zarattee/velocista/img/TQFP_ARDUINO_PINOUT.jpg

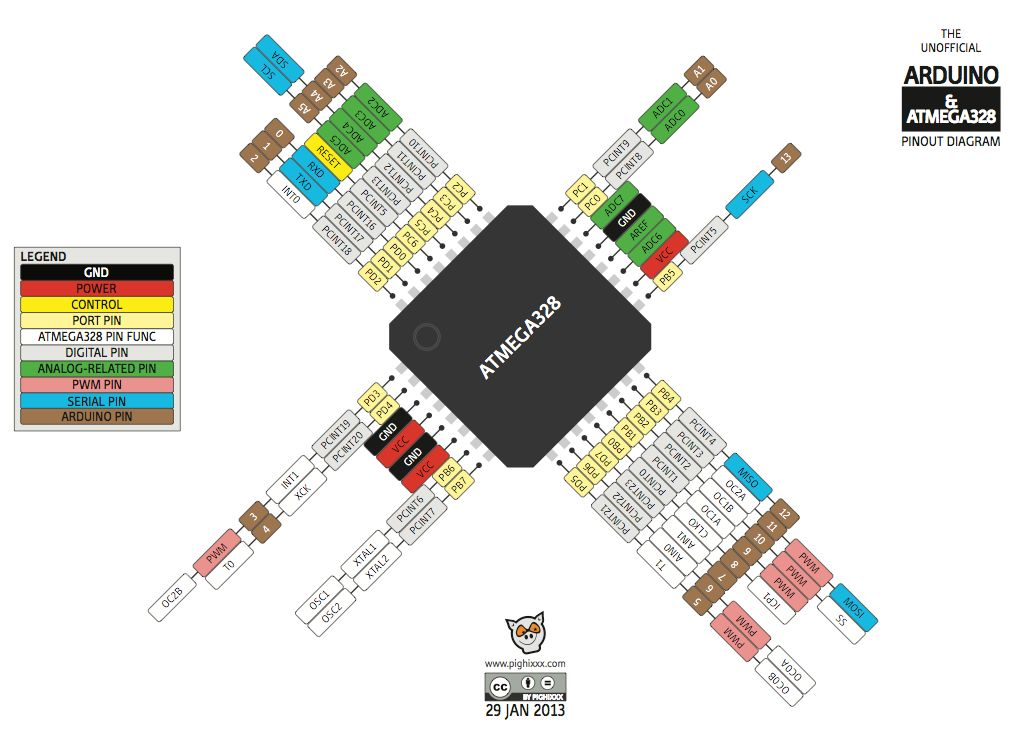
img/TQFP_ARDUINO_PINOUT.jpg
