zarattee/velocista/img/3D_VIEW_C.jpg

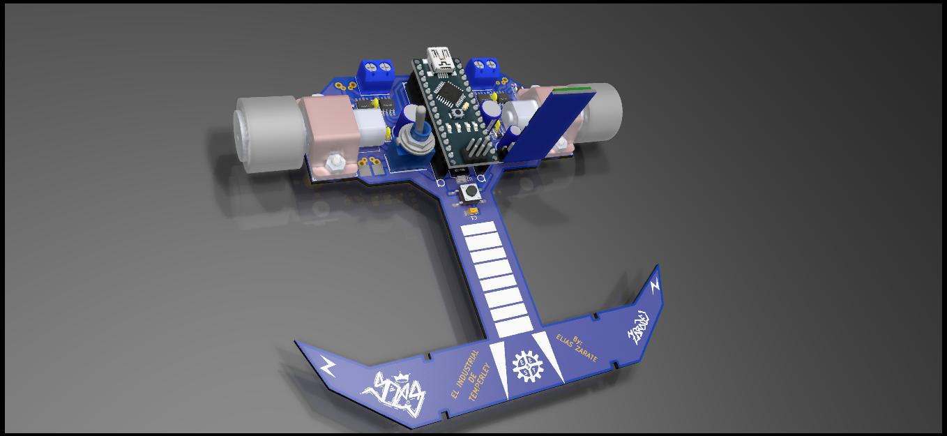
img/3D_VIEW_C.jpg
