zarattee/velocista/img/3D_VIEW.jpg

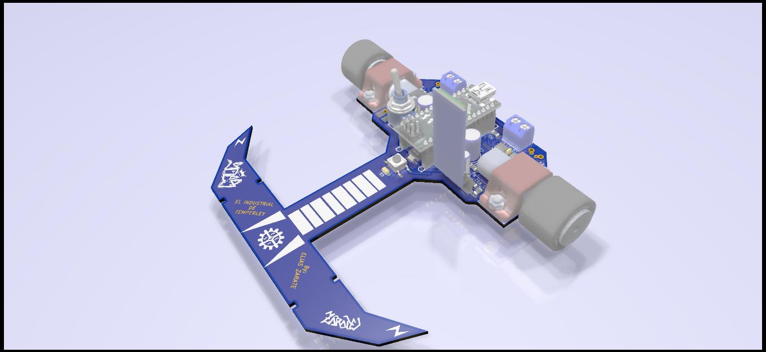
img/3D_VIEW.jpg
