zarattee/velocista/img/3D_VIEW_D.jpg

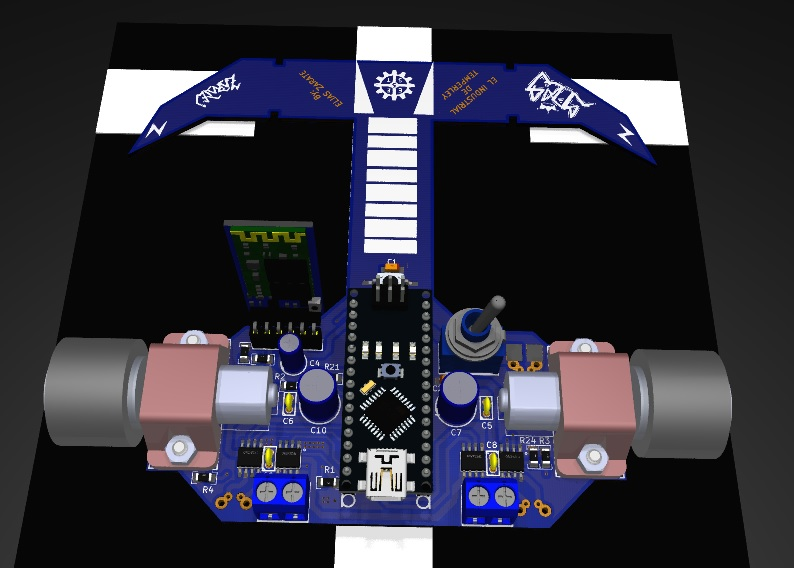
img/3D_VIEW_D.jpg
