zarattee/velocista/img/Config_Drill.jpg

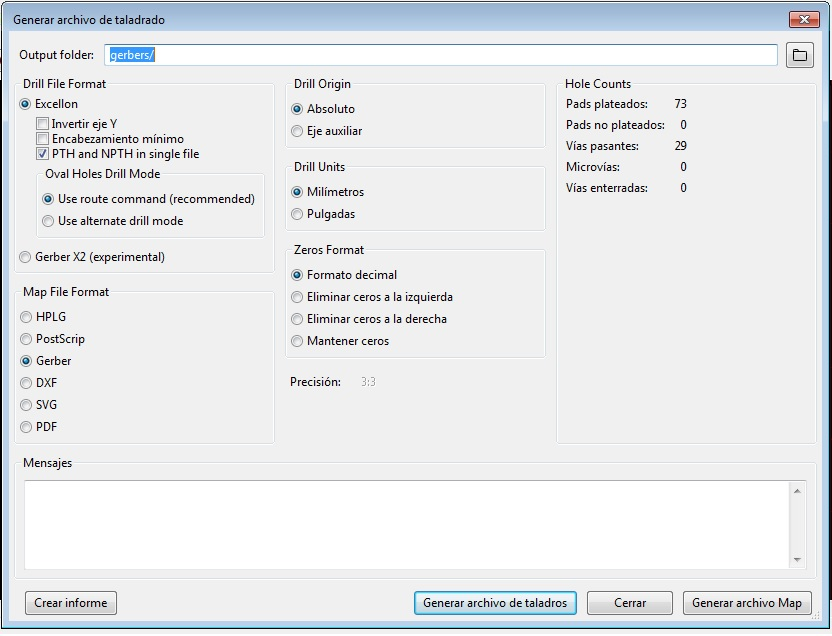
img/Config_Drill.jpg
