zarattee/velocista/doc/BOM_Velocista.xls

Sheet: LISTA DE MATERIALES
Lista de materiales
Proyecto: |  | Robot Velocista con 2 helices
Curso: |  | 4Dev
Fecha: |  | 2021-01-08
Autor: |  | Elias Zarate
Moneda: |  | USD | Tipo de cambio: -
 | Designator | Footprint | CANT. | Value | U. Price | Subtotal | % | Proveedor | MPN | DIGI-KEY PART NUMBER
1 | J1 | arduino_nano_header | 1 | Arduino_Nano_Header | 0.440 | 0.440 | 0.65% | ML
2 | C1 | CAP_TAN_A | 1 | 10UF | 0.286 | 0.286 | 0.42% | Digikey.link (https://www.digikey.com/en/products/detail/kemet/T491A106M016AT/818548) | T491A106M016AT | 399-3687-2-ND
3 | SW | Pulsador_4_SMD | 1 | START | 0.177 | 0.177 | 0.26% | Digikey.link (https://www.digikey.com/en/products/detail/e-switch/TL3305AF160QG/5816181) | TL3305AF160QG | EG5350TR-ND
4 | SW3 | SW_SPDT_TH_Vertical | 1 | SW_SPDT | 1.150 | 1.150 | 1.70% | Monarca.link (https://www.monarcaelectronica.com.ar/productos/interruptor-de-palanca-3-pines-na-nc-3a-250v-mona/)
5 | J2,J3,J4,J6,J7 | BORNERA2_DUO | 5 | ALIMENTACION | 0.150 | 0.750 | 1.11% | ELEMON | XY305-2P AZUL | BO5811900
6 | J5 | HC-05 | 1 | BLUETOOTH | 0.110 | 0.110 | 0.16% | ML
7 | C9,C8,C6,C5 | CAP_0.1 | 4 | 100nf | 0.110 | 0.438 | 0.65% | Digikey.link (https://www.digikey.com/en/products/detail/kemet/C315C104M5U5TA/817927) | C315C104M5U5TA | 399-4151-ND
8 | R2,R9,R10,R11,R12,R17,R18,R19,R20 | R_1206 | 9 | 10K | 0.027 | 0.246 | 0.36% | Digikey.link (https://www.digikey.com/en/products/detail/te-connectivity-passive-product/CRG1206F10K/2389909) | CRG1206F10K | A106069TR-ND
9 | U13,U1,U11,U12 | SSOP-8 | 4 | DRV8872 | 2.428 | 9.712 | 14.39% | Digikey.link (https://www.digikey.com/en/products/detail/texas-instruments/DRV8872DDA/6571845) | DRV8872DDA | 296-46512-5-ND
10 | C4 | CAP_ELEC_5x11mm | 1 | 100uf | 0.100 | 0.100 | 0.15% | Digikey.link (https://www.digikey.com/en/products/detail/w%C3%BCrth-elektronik/860010372006/5728555) | 860010372006 | 732-8598-1-ND
11 | C3 | C_1206 | 1 | 100nf | 0.036 | 0.036 | 0.05% | Digikey.link (https://www.digikey.com/en/products/detail/kemet/C1206C104K5RAC7800/411248) | C1206C104K5RAC7800 | 399-C1206C104K5RAC7800CT-ND
12 | C2 | CAP_TAN_A | 1 | 100uf | 0.616 | 0.616 | 0.91% | Digikey.link (https://www.digikey.com/en/products/detail/avx-corporation/F931C107MCCAJ6/6156133) | F931C107MCCAJ6 | 478-9997-2-ND
13 | R5,R6,R7,R8,R13,R14,R15,R16 | R_1206 | 8 | 220 | 0.027 | 0.213 | 0.32% | Digikey.link (https://www.digikey.com/en/products/detail/vishay-dale/CRCW1206220RFKEA/1176566) | CRCW1206220RFKEA | 541-220FTR-ND
14 | R21,R22,R23 | R_1206 | 3 | 1K | 0.028 | 0.083 | 0.12% | Digikey.link (https://www.digikey.com/en/products/detail/te-connectivity-passive-product/CRGCQ1206F1K0/8576412) | CRGCQ1206F1K0 | A129810TR-ND
15 | U2 | SOT223 | 1 | LM1117-SOT | 0.985 | 0.985 | 1.46% | Digikey.link (https://www.digikey.com/en/products/detail/texas-instruments/LM1117MP-5-0-NOPB/363590) | LM1117MP-5.0/NOPB | LM1117MP-5.0/NOPBTR-ND
16 | U3,U4,U5,U6,U7,U8,U9,U10 | QRE1113GR | 8 | QRE1113 | 0.667 | 5.336 | 7.91% | Digikey.link (https://www.digikey.com/en/products/detail/on-semiconductor/QRE1113GR/965451) | QRE1113GR | QRE1113GRTR-ND
17 | C7,C10 | CAP_ELEC_8x11.5mm | 2 | 100uF | 1.733 | 3.466 | 5.14% | Digikey.link (https://www.digikey.com/en/products/detail/cornell-dubilier-electronics-cde/SEK101M050ST/1627120) | SEK101M050ST | 338-1725-ND
19 | R3,R4,R1,R24 | R_1206 | 4 | Rsense | 0.363 | 1.452 | 2.15% | Digikey.link (https://www.digikey.com/en/products/detail/panasonic-electronic-components/ERJ-8CWJR025V/4927026) | ERJ-8CWJR025V | P0.025BWTR-ND
20 | PCB |  | 1 |  | 10.000 | 10.000 | 14.82%
21 | Motor | Micro motor Pololu 6000rpm 6V | 2 |  | 15.950 | 31.900 | 47.26% | Digikey.link (https://www.digikey.com/en/products/detail/pololu-corporation/1000/10449928) | 1000 | 2183-1000-ND
 |  | Notas |  |  | TOTAL | 67.495
 | https://www.jsumo.com/storm-pid-controlled-fast-line-follower |  |  |  |  | 290
 | https://www.sumozade.com/en/product/linecraft-fast-line-follower-robot-kit-4000rpm-assembled |  |  |  |  | 279
 | https://ja-bots.com/producto/seguidor-de-linea-fastbot/ |  |  |  |  | 160

Sheet: PCBA
Lista de materiales
Proyecto: |  | Robot Velocista con 2 helices
Curso: |  | 4Dev
Fecha: |  | 2021-01-08
Autor: |  | Elias Zarate
Moneda: |  | USD | Tipo de cambio: -
 | Designator | Footprint | CANT. | Value | Proveedor | MPN | DIGI-KEY PART NUMBER
1 | J1 | arduino_nano_header | 1 | Arduino_Nano_Header
2 | C1 | CAP_TAN_A | 1 | 10uF 16V | Digikey.link (https://www.digikey.com/en/products/detail/kemet/T491A106M016AT/818548) | T491A106M016AT | 399-3687-2-ND
3 | SW | Pulsador_4_SMD | 1 | START | Digikey.link (https://www.digikey.com/en/products/detail/e-switch/TL3305AF160QG/5816181) | TL3305AF160QG | EG5350TR-ND
4 | SW3 | SW_SPDT_TH_Vertical | 1 | SW_SPDT | Monarca.link (https://www.monarcaelectronica.com.ar/productos/interruptor-de-palanca-3-pines-na-nc-3a-250v-mona/)
5 | J2,J3,J4,J6,J7 | BORNERA2_DUO | 5 | Paso 5mm | ELEMON | XY305-2P AZUL | BO5811900
6 | J5 | HC-05 | 1 | BLUETOOTH | ML
7 | C9,C8,C6,C5 | CAP_0.1 | 4 | 100nf | Digikey.link (https://www.digikey.com/en/products/detail/kemet/C315C104M5U5TA/817927) | C315C104M5U5TA | 399-4151-ND
8 | R2,R9,R10,R11,R12,R17,R18,R19,R20 | R_1206 | 9 | 10K | Digikey.link (https://www.digikey.com/en/products/detail/te-connectivity-passive-product/CRG1206F10K/2389909) | CRG1206F10K | A106069TR-ND
9 | U13,U1,U11,U12 | SSOP-8 | 4 | DRV8872 | Digikey.link (https://www.digikey.com/en/products/detail/texas-instruments/DRV8872DDA/6571845) | DRV8872DDA | 296-46512-5-ND
10 | C4 | CAP_ELEC_5x11mm | 1 | 100uF 16V | Digikey.link (https://www.digikey.com/en/products/detail/w%C3%BCrth-elektronik/860010372006/5728555) | 860010372006 | 732-8598-1-ND
11 | C3 | C_1206 | 1 | 100nF 50V | Digikey.link (https://www.digikey.com/en/products/detail/kemet/C1206C104K5RAC7800/411248) | C1206C104K5RAC7800 | 399-C1206C104K5RAC7800CT-ND
12 | C2 | CAP_TAN_A | 1 | 100uF 16V | Digikey.link (https://www.digikey.com/en/products/detail/avx-corporation/F931C107MCCAJ6/6156133) | F931C107MCCAJ6 | 478-9997-2-ND
13 | R5,R6,R7,R8,R13,R14,R15,R16 | R_1206 | 8 | 220 | Digikey.link (https://www.digikey.com/en/products/detail/vishay-dale/CRCW1206220RFKEA/1176566) | CRCW1206220RFKEA | 541-220FTR-ND
14 | R21,R22,R23 | R_1206 | 3 | 1K | Digikey.link (https://www.digikey.com/en/products/detail/te-connectivity-passive-product/CRGCQ1206F1K0/8576412) | CRGCQ1206F1K0 | A129810TR-ND
15 | U2 | SOT223 | 1 | LM1117-SOT | Digikey.link (https://www.digikey.com/en/products/detail/texas-instruments/LM1117MP-5-0-NOPB/363590) | LM1117MP-5.0/NOPB | LM1117MP-5.0/NOPBTR-ND
16 | U3,U4,U5,U6,U7,U8,U9,U10 | QRE1113GR | 8 | QRE1113GR | Digikey.link (https://www.digikey.com/en/products/detail/on-semiconductor/QRE1113GR/965451) | QRE1113GR | QRE1113GRTR-ND
17 | C7,C10 | CAP_ELEC_8x11.5mm | 2 | 100uF 16V | Digikey.link (https://www.digikey.com/en/products/detail/cornell-dubilier-electronics-cde/SEK101M050ST/1627120) | SEK101M050ST | 338-1725-ND
19 | R3,R4,R1,R24 | R_1206 | 4 | Rsense | Digikey.link (https://www.digikey.com/en/products/detail/panasonic-electronic-components/ERJ-8CWJR025V/4927026) | ERJ-8CWJR025V | P0.025BWTR-ND
20 | PCB |  | 1
 |  | Notas
