zarattee/velocista/doc/lista de componentes.xls

Lista de materiales
Proyecto:
Curso:
Fecha:
Autor:
Moneda: |  | $ (Pesos) | Tipo de cambio: -
 | Designator | Footprint | CANT. | Value | Unit Price | Subtotal | Proveedor | MPN | DIGI-KEY PART NUMBER
1 | J1 | arduino_nano_header | 1 | Arduino_Nano_Header |  | 0.00
2 | C1 | CAP_TAN_A | 1 | 10UF |  | 0.00 | https://www.digikey.com/en/products/detail/kemet/T491A106M016AT/818548 | T491A106M016AT | 399-3687-2-ND
3 | SW | Pulsador_4_SMD | 1 | START |  | 0.00 | https://www.digikey.com/en/products/detail/e-switch/TL3305AF160QG/5816181 | TL3305AF160QG | EG5350TR-ND
4 | SW3 | SW_SPDT_TH_Vertical | 1 | SW_SPDT |  | 0.00
5 | J2,J3,J4,J6,J7 | BORNERA2_DUO | 5 | ALIMENTACION,BORNES DE LOS MOTORES |  | 0.00
6 | J5 | HC-05 | 1 | BLUETOOTH |  | 0.00
7 | C9,C8,C6,C5 | CAP_0.1 | 4 | 100nf |  | 0.00
8 | R2,R9,R10,R11,R12,R17,R18,R19,R20 | R_1206 | 9 | 10K |  | 0.00 | https://www.digikey.com/en/products/detail/te-connectivity-passive-product/CRG1206F10K/2389909 | CRG1206F10K | A106069TR-ND
9 | U13,U1,U11,U12 | SSOP-8 | 4 | DRV8872 |  | 0.00 | https://www.digikey.com/en/products/detail/texas-instruments/DRV8872DDA/6571845 | DRV8872DDA | 296-46512-5-ND
10 | C4 | CAP_ELEC_5x11mm | 1 | 100uf |  | 0.00 | https://www.digikey.com/en/products/detail/w%C3%BCrth-elektronik/860010372006/5728555 | 860010372006 | 732-8598-1-ND
11 | C3 | C_1206 | 1 | 100nf |  | 0.00 | https://www.digikey.com/en/products/detail/samsung-electro-mechanics/CL10B104KC8VPNC/11487748 | CL10B104KC8VPNC | 1276-CL10B104KC8VPNCTR-ND
12 | C2 | CAP_TAN_A | 1 | 100uf |  |  | https://www.digikey.com/en/products/detail/avx-corporation/F931C107MCCAJ6/6156133 | F931C107MCCAJ6 | 478-9997-2-ND
13 | R5,R6,R7,R8,R13,R14,R15,R16 | R_1206 | 8 | 220 |  |  | https://www.digikey.com/en/products/detail/vishay-dale/CRCW1206220RFKEA/1176566 | CRCW1206220RFKEA | 541-220FTR-ND
14 | R21,R22,R23 | R_1206 | 3 | 1K |  |  | https://www.digikey.com/en/products/detail/te-connectivity-passive-product/CRGCQ1206F1K0/8576412 | CRGCQ1206F1K0 | A129810TR-ND
15 | U2 | SOT223 | 1 | LM1117-SOT |  |  | https://www.digikey.com/en/products/detail/texas-instruments/LM1117MP-5-0-NOPB/363590 | LM1117MP-5.0/NOPB | LM1117MP-5.0/NOPBTR-ND
16 | U3,U4,U5,U6,U7,U8,U9,U10 | QRE1113GR | 8 | QRE1113 |  |  | https://www.digikey.com/en/products/detail/on-semiconductor/QRE1113GR/965451 | QRE1113GR | QRE1113GRTR-ND
17 | C7,C10 | CAP_ELEC_8x11.5mm | 2 | 1OOuf |  |  | https://www.digikey.com/en/products/detail/rubycon/16YXG100MEFC5X11/3134093 | 16YXG100MEFC5X11 | 1189-1135-ND
18 | R3,R24 | R_1206 | 2 | 0.25 |  | 0.00
19 | R4,R1 | R_1206 | 1 | Rsense |  | 0.00 | https://www.digikey.com/en/products/detail/panasonic-electronic-components/ERJ-8CWJR025V/4927026 | ERJ-8CWJR025V | P0.025BWTR-ND
20 |  |  |  |  |  | 0.00
21 |  |  |  |  |  | 0.00
22 |  |  |  |  |  | 0.00
23 |  |  |  |  |  | 0.00
24 |  |  |  |  |  | 0.00
25 |  |  |  |  |  | 0.00
 |  | Notas |  |  | TOTAL | 0.00
