zarattee/velocista/VELOCISTA.kicad_pcb

## KiCad design VELOCISTA.kicad_pcb (2020-10-19)

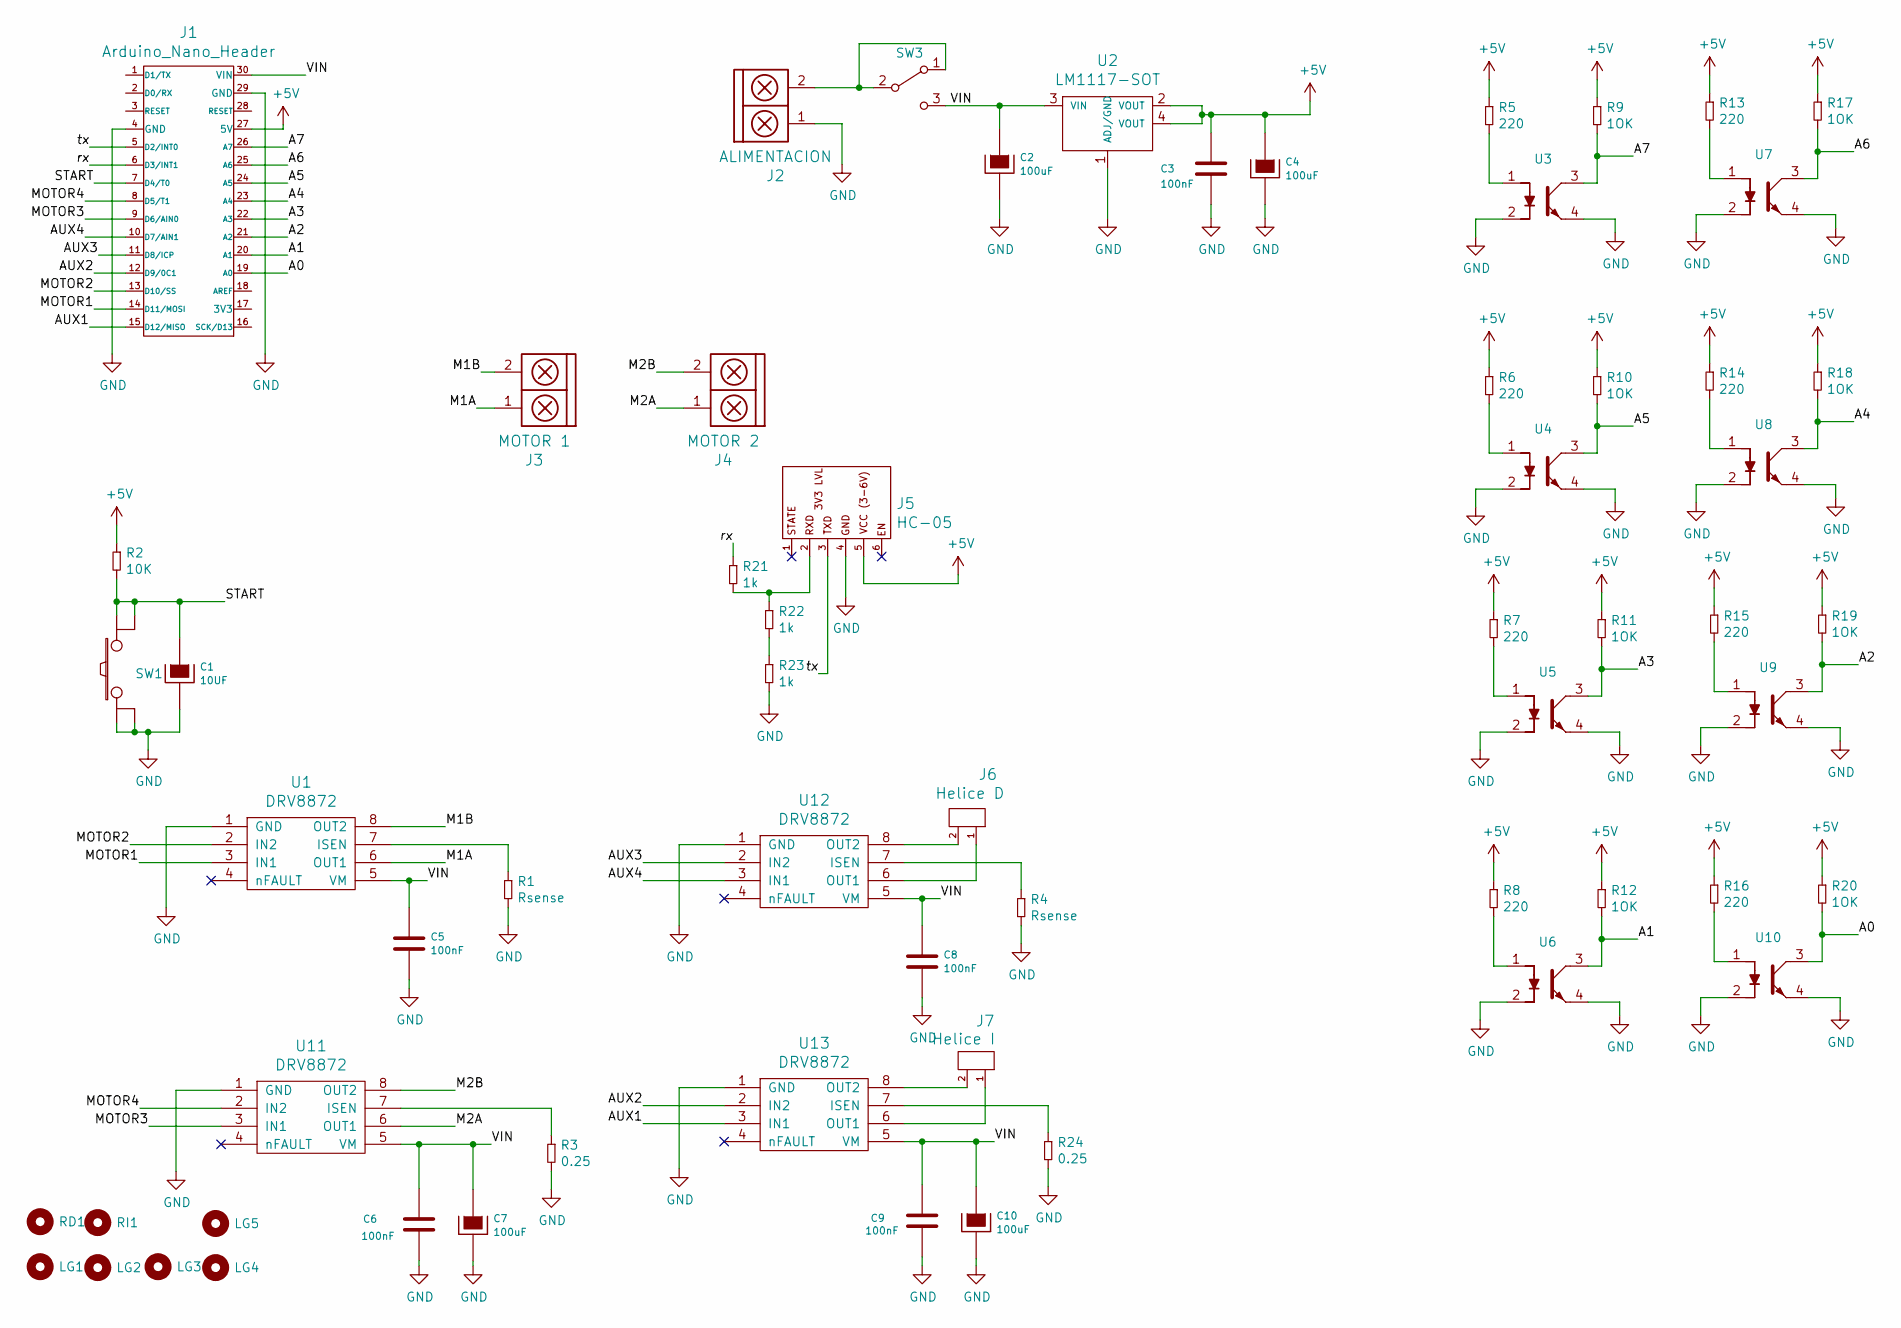
[picture p6: schematic VELOCISTA.sch, Robot Velocista]

Parts:
C1: 10UF; CAP_TAN_A
C2: 100uF; CAP_TAN_A
C3: 100nF; C_1206
C4: 100uF; CAP_ELEC_5x11mm
C5, C6, C8, C9: 100nF; CAP_0.1
C7, C10: 100uF; CAP_ELEC_8x11.5mm
J1: Arduino_Nano_Header; arduino_nano_header
J2: ALIMENTACION; BORNERA2_DUO
J3: MOTOR 1; BORNERA2_AZUL
J4: MOTOR 2; BORNERA2_AZUL
J5: HC-05
J6: Helice D; BORNERA2_DUO
J7: Helice I; BORNERA2_DUO
LG1: Mounting_Hole; LOGO_EESTN5
LG2: Mounting_Hole; Logo_Zarate
LG3: Mounting_Hole; Logo_Zarate_Nombre
LG4, LG5: Mounting_Hole; Logo_Rayo
R1, R4: Rsense; R_1206
R2: 10K; R_1206
R3, R24: 0.25; R_1206
R5, R6, R7, R8, R13, R14, R15, R16: 220; R_1206
R9, R10, R11, R12, R17, R18, R19, R20: 1OK; R_1206
R21, R22, R23: 1k; R_1206
RD1: Mounting_Hole; Pololu_Micro_Con_Soporte_Simple
RI1: Mounting_Hole; Pololu_Micro_Con_Soporte_Simple
SW1: SW_PUSH; Pulsador_4_SMD
SW3: SW_SPDT; SW_SPDT_TH_Vertical
U1, U11, U12, U13: DRV8872; SSOP-8
U2: LM1117-SOT; SOT223
U3, U4, U5, U6, U7, U8, U9, U10: QRE1113; QRE1113GR

Connections:
+5V: C3.1, C4.1, J1.27 (5V), J5.5, R2.1, R5.1, R6.1, R7.1, R8.1, R9.1, R10.1, R11.1, R12.1, R13.1, R14.1, R15.1, R16.1, R17.1, R18.1, R19.1, R20.1, U2.2 (VOUT), U2.4 (VOUT)
/A0: J1.19 (A0), R20.2, U10.3
/A1: J1.20 (A1), R12.2, U6.3
/A2: J1.21 (A2), R19.2, U9.3
/A3: J1.22 (A3), R11.2, U5.3
/A4: J1.23 (A4), R18.2, U8.3
/A5: J1.24 (A5), R10.2, U4.3
/A6: J1.25 (A6), R17.2, U7.3
/A7: J1.26 (A7), R9.2, U3.3
/AUX1: J1.15 (D12/MISO), U13.3 (IN1)
/AUX2: J1.12 (D9/0C1), U13.2 (IN2)
/AUX3: J1.11 (D8/ICP), U12.2 (IN2)
/AUX4: J1.10 (D7/AIN1), U12.3 (IN1)
/M1A: J3.1, U1.6 (OUT1)
/M1B: J3.2, U1.8 (OUT2)
/M2A: J4.1, U11.6 (OUT1)
/M2B: J4.2, U11.8 (OUT2)
/MOTOR1: J1.14 (D11/MOSI), U1.3 (IN1)
/MOTOR2: J1.13 (D10/SS), U1.2 (IN2)
/MOTOR3: J1.9 (D6/AIN0), U11.3 (IN1)
/MOTOR4: J1.8 (D5/T1), U11.2 (IN2)
/START: C1.1, J1.7 (D4/T0), R2.2, SW1.3, SW1.4
/VIN: C2.1, C5.1, C6.1, C7.1, C8.1, C9.1, C10.1, J1.30 (VIN), SW3.3 (C), U1.5 (VM), U2.3 (VIN), U11.5 (VM), U12.5 (VM), U13.5 (VM)
/rx: J1.6 (D3/INT1), R21.1
/tx: J1.5 (D2/INT0), J5.3
GND: C1.2, C2.2, C3.2, C4.2, C5.2, C6.2, C7.2, C8.2, C9.2, C10.2, J1.4 (GND), J1.29 (GND), J2.1, J5.4, R1.2, R3.2, R4.2, R23.2, R24.2, SW1.1, SW1.2, U1.1 (GND), U2.1 (ADJ/GND), U3.2, U3.4, U4.2, U4.4, U5.2, U5.4, U6.2, U6.4, U7.2, U7.4, U8.2, U8.4, U9.2, U9.4, U10.2, U10.4, U11.1 (GND), U12.1 (GND), U13.1 (GND)
unnamed: J2.2, SW3.1 (A), SW3.2 (B)
unnamed: J5.2, R21.2, R22.1
unnamed: J6.1, U12.6 (OUT1)
unnamed: J6.2, U12.8 (OUT2)
unnamed: J7.1, U13.6 (OUT1)
unnamed: J7.2, U13.8 (OUT2)
unnamed: R1.1, U1.7 (ISEN)
unnamed: R3.1, U11.7 (ISEN)
unnamed: R4.1, U12.7 (ISEN)
unnamed: R5.2, U3.1
unnamed: R6.2, U4.1
unnamed: R7.2, U5.1
unnamed: R8.2, U6.1
unnamed: R13.2, U7.1
unnamed: R14.2, U8.1
unnamed: R15.2, U9.1
unnamed: R16.2, U10.1
unnamed: R22.2, R23.1
unnamed: R24.1, U13.7 (ISEN)

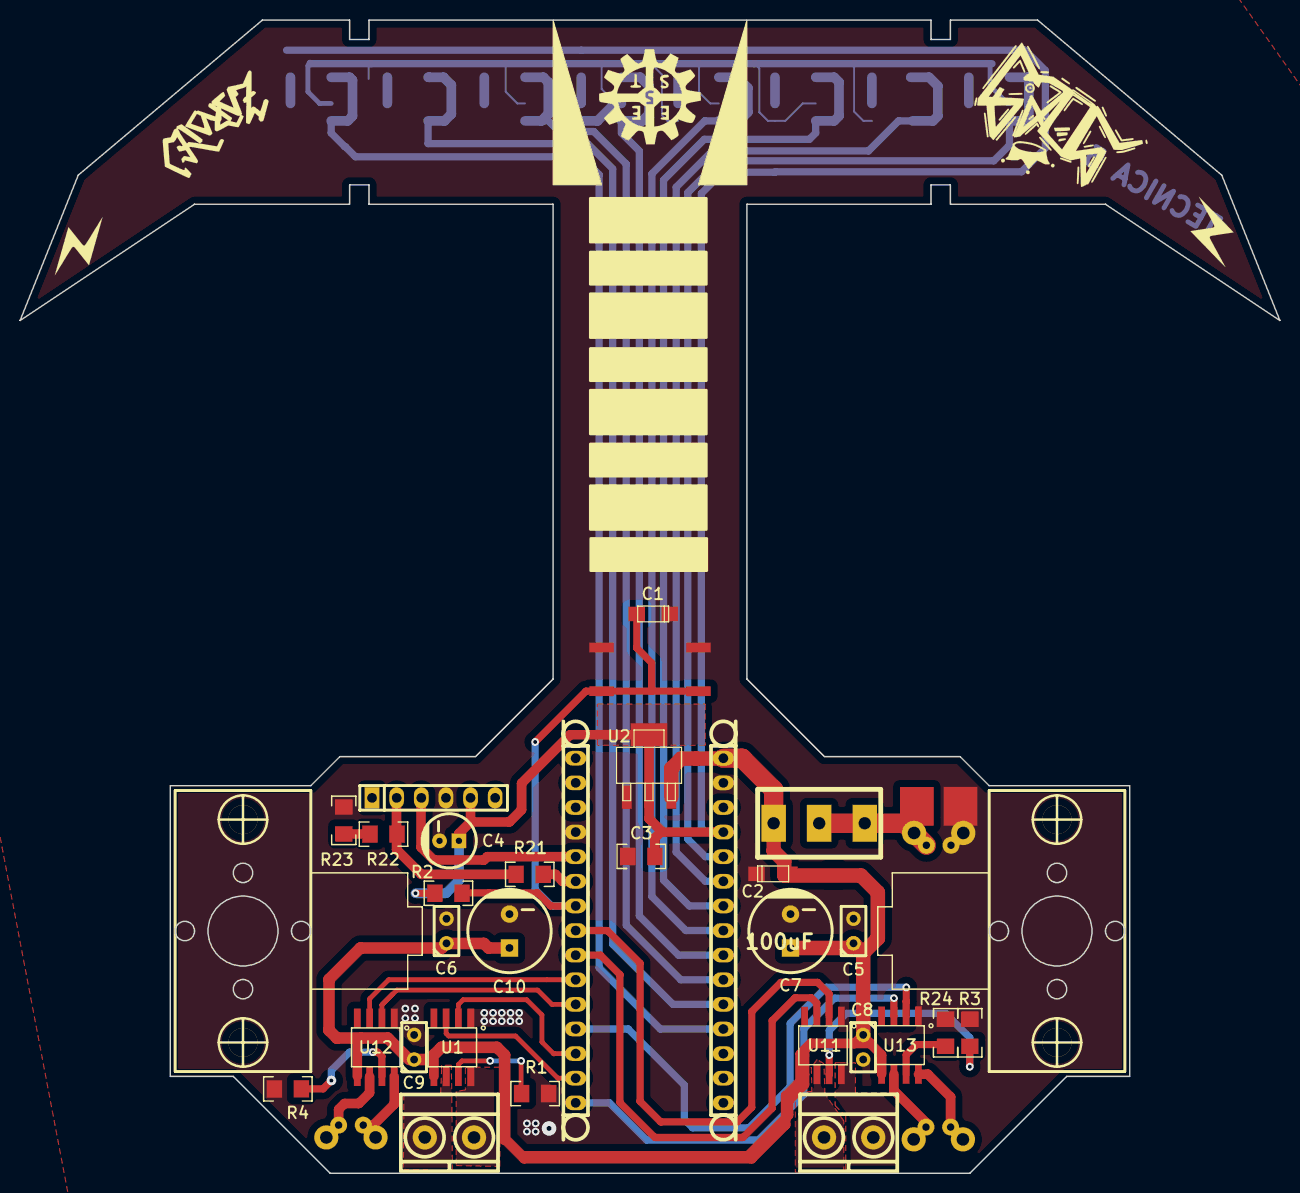
[picture p7: board VELOCISTA.kicad_pcb from above]

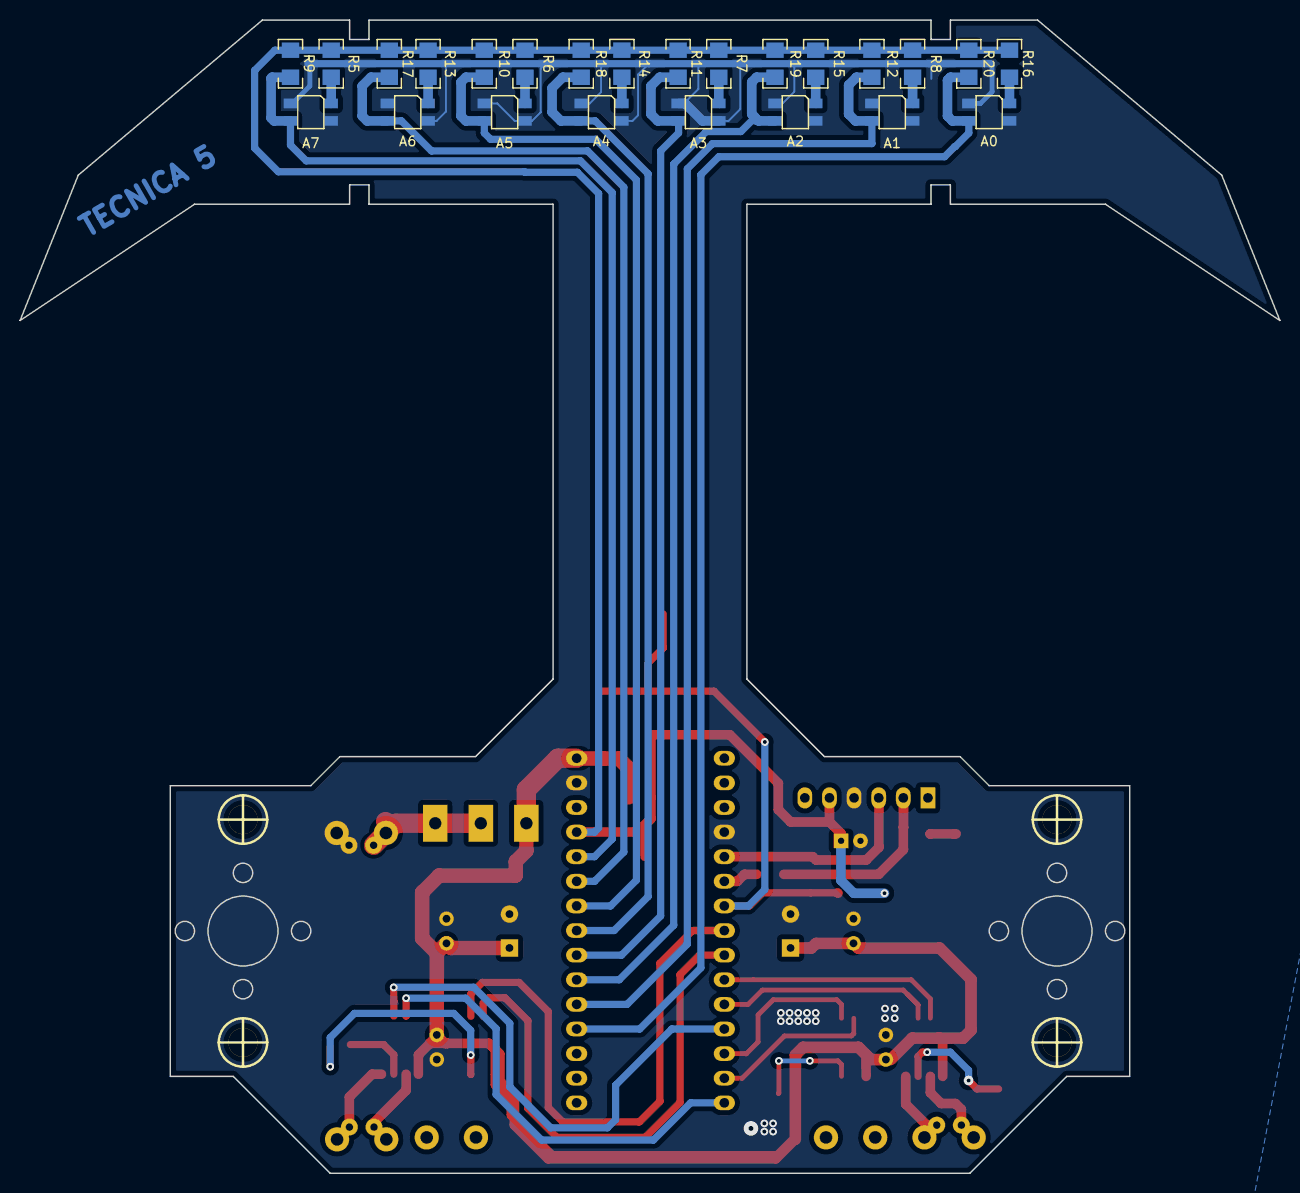
[picture p8: board VELOCISTA.kicad_pcb from below]

Board: 2 copper layers, 130.0 x 119.0 mm, 63 parts (24 on the bottom side), 45 nets.
