zarattee/velocista/(commit log)

2020-10-19 actualizacion inicial
    [VELOCISTA (Copia en conflicto de Elias Zarate 2019-10-29).kicad_pcb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]
2020-10-19 Pinout Atmega328p
    Grafica con descripcion de los pines del uC utilizado
2020-10-19 How to gerbers
    Guía para la generación de archivos de fabricación
2020-10-19 Ejemplo de modificación cruzada
    Recomendación para Elias
2020-10-20 se ignora variable de entorno
    se agrego un archivo no aceptable
2020-10-20 Render & BOM
    Generación de las imagenes del modelo 3D del proyecto desde diferentes vistas/configuraciones.
    Incorporación de la lista de materiales interactiva.
2020-10-20 eliminacion de archivos innecesarios
    eleminacion de archivos en conflicot con los archivo originales
    [VELOCISTA (Copia en conflicto de Elias Zarate 2019-10-29).kicad_pcb]
2020-10-30 Actualizacion del archivo de taladros
    Se actualizo el archivo de taladros verificando el formato requerido por el fabricante.
    Se agrego la captura de pantalla de la configuracion utilizada para futura referencia.
    Se agrego el archivo comprimido con los gerbers enviados al fabricante.
    [VELOCISTA-drill.drl]
2020-11-06 lista de componentes
    se agrego lista de componentees de la placa
    [lista de componentes.xls]
2020-11-27 se agrega lista de componentes
    se agrega lista de componentes y
    como proveedor https://www.digikey.com
    [lista de componentes.xls]
2021-01-08 Actualización BOM
    Se cambió el formato de la lista de materiales y se completaron los datos para un costeo inicial del equipo
    [BOM_Velocista.xls]
2021-01-08 Actualizacion BOM II
    Cambios de formato y generación de la BOM inicial en pdf
    [BOM_Velocista.xls]
2021-01-13 BOM PCBA
    Generé el archivo individual para enviar a presupuestar la adquisición de materiales
    [BOM_Velocista.xls, BOM_Velocista_PCBA.xls]
